baldengineer/Game-Gear-Cartridge-Breakout/game gear shim v11.stl

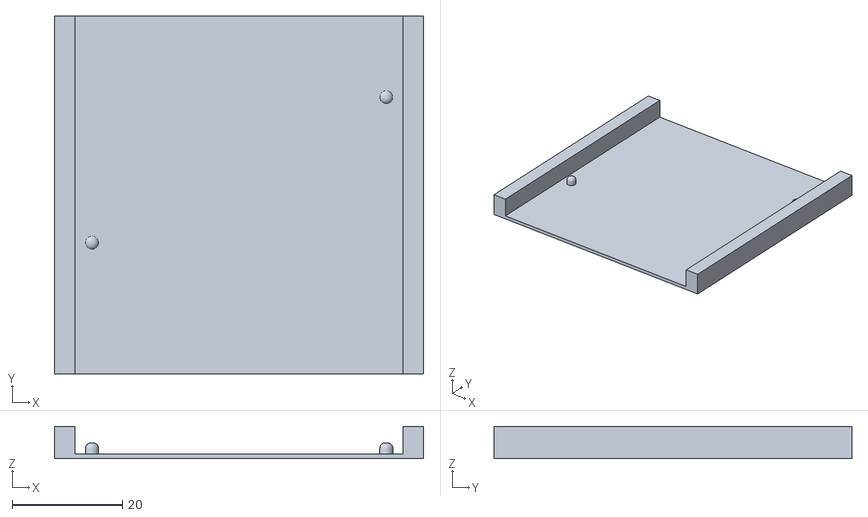
[picture p1: CAD file, 2023-01-09]
game gear shim v11.stl
67.0 x 65.0 x 5.90
