baldengineer/Game-Gear-Cartridge-Breakout/Game Gear Breakout Schematic v1.pdf

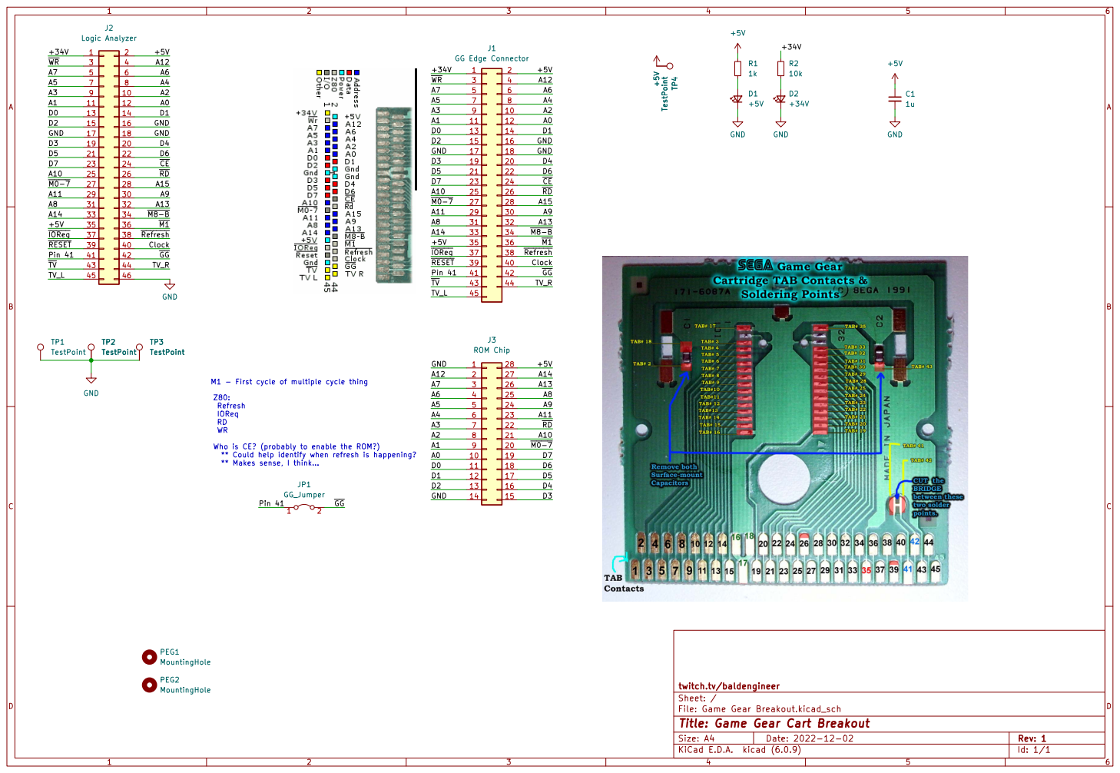
[picture p2: page 1]

Refresh
IOReq
WR Who is CE? (probably to enable the ROM?)

** Could help identify when refresh is happening?

File: Game Gear Breakout.kicad_sch Sheet: / twitch.tv/baldengineer

Id: 1/1 Title: Game Gear Cart Breakout
