baldengineer/Game-Gear-Cartridge-Breakout/Game Gear Breakout.kicad_pcb

## KiCad design Game Gear Breakout.kicad_pcb (2023-01-09)

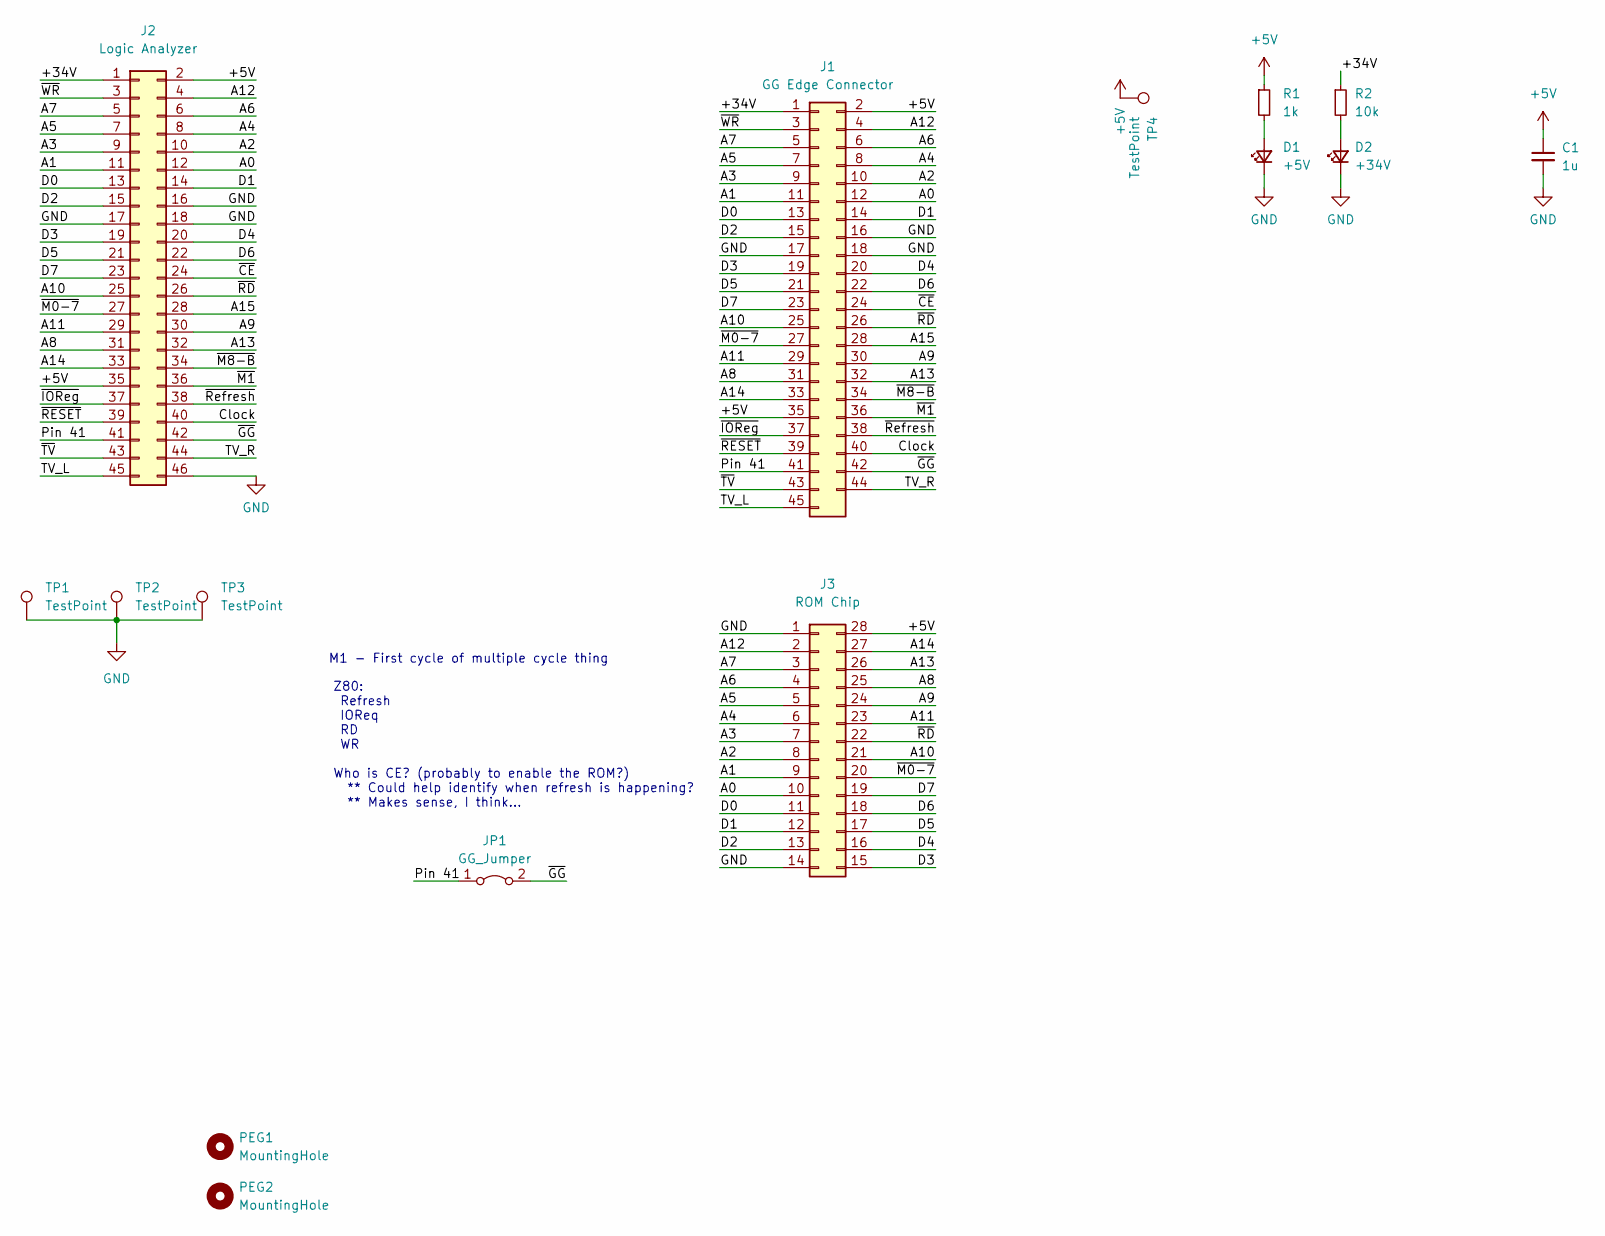
[picture p3: schematic Game Gear Breakout.kicad_sch, Game Gear Cart Breakout]

Parts:
C1: 1u; C_0805_2012Metric_Pad1.18x1.45mm_HandSolder
D1: +5V; LED_1206_3216Metric_Pad1.42x1.75mm_HandSolder
D2: +34V; LED_1206_3216Metric_Pad1.42x1.75mm_HandSolder
J1: GG Edge Connector; game gear edge connector
J2: Logic Analyzer; PinHeader_2x23_P2.54mm_Vertical
J3: ROM Chip; SOIC-28W_7.5x17.9mm_P1.27mm
JP1: GG_Jumper; SolderJumper-2_P1.3mm_Bridged_RoundedPad1.0x1.5mm
PEG1, PEG2: MountingHole; MountingHole_2.7mm_M2.5
R1: 1k; R_0805_2012Metric_Pad1.20x1.40mm_HandSolder
R2: 10k; R_0805_2012Metric_Pad1.20x1.40mm_HandSolder
TP1, TP2, TP3, TP4: TestPoint; Harwin-S1751-46-Test-Point

Connections:
+5V: C1.1, J1.2, J1.35, J2.2, J2.35, J3.28, R1.1, TP4.1
/+34V: J1.1, J2.1, R2.1
/A0: J1.12, J2.12, J3.10
/A1: J1.11, J2.11, J3.9
/A2: J1.10, J2.10, J3.8
/A3: J1.9, J2.9, J3.7
/A4: J1.8, J2.8, J3.6
/A5: J1.7, J2.7, J3.5
/A6: J1.6, J2.6, J3.4
/A7: J1.5, J2.5, J3.3
/A8: J1.31, J2.31, J3.25
/A9: J1.30, J2.30, J3.24
/A10: J1.25, J2.25, J3.21
/A11: J1.29, J2.29, J3.23
/A12: J1.4, J2.4, J3.2
/A13: J1.32, J2.32, J3.26
/A14: J1.33, J2.33, J3.27
/A15: J1.28, J2.28
/Clock: J1.40, J2.40
/D0: J1.13, J2.13, J3.11
/D1: J1.14, J2.14, J3.12
/D2: J1.15, J2.15, J3.13
/D3: J1.19, J2.19, J3.15
/D4: J1.20, J2.20, J3.16
/D5: J1.21, J2.21, J3.17
/D6: J1.22, J2.22, J3.18
/D7: J1.23, J2.23, J3.19
/Pin 41: J1.41, J2.41, JP1.1 (A)
/TV_L: J1.45, J2.45
/TV_R: J1.44, J2.44
/~CE: J1.24, J2.24
/~GG: J1.42, J2.42, JP1.2 (B)
/~IOReg: J1.37, J2.37
/~M0-7: J1.27, J2.27, J3.20
/~M1: J1.36, J2.36
/~M8-B: J1.34, J2.34
/~RD: J1.26, J2.26, J3.22
/~RESET: J1.39, J2.39
/~Refresh: J1.38, J2.38
/~TV: J1.43, J2.43
/~WR: J1.3, J2.3
GND: C1.2, D1.1 (K), D2.1 (K), J1.16, J1.17, J1.18, J2.16, J2.17, J2.18, J2.46, J3.1, J3.14, TP1.1, TP2.1, TP3.1
unnamed: D1.2 (A), R1.2
unnamed: D2.2 (A), R2.2

Notes on the sheet:
Z80: Refresh IOReq RD WR Who is CE? (probably to enable the ROM?) ** Could help identify when refresh is happening? ** Makes sense, I think...
M1 - First cycle of multiple cycle thing

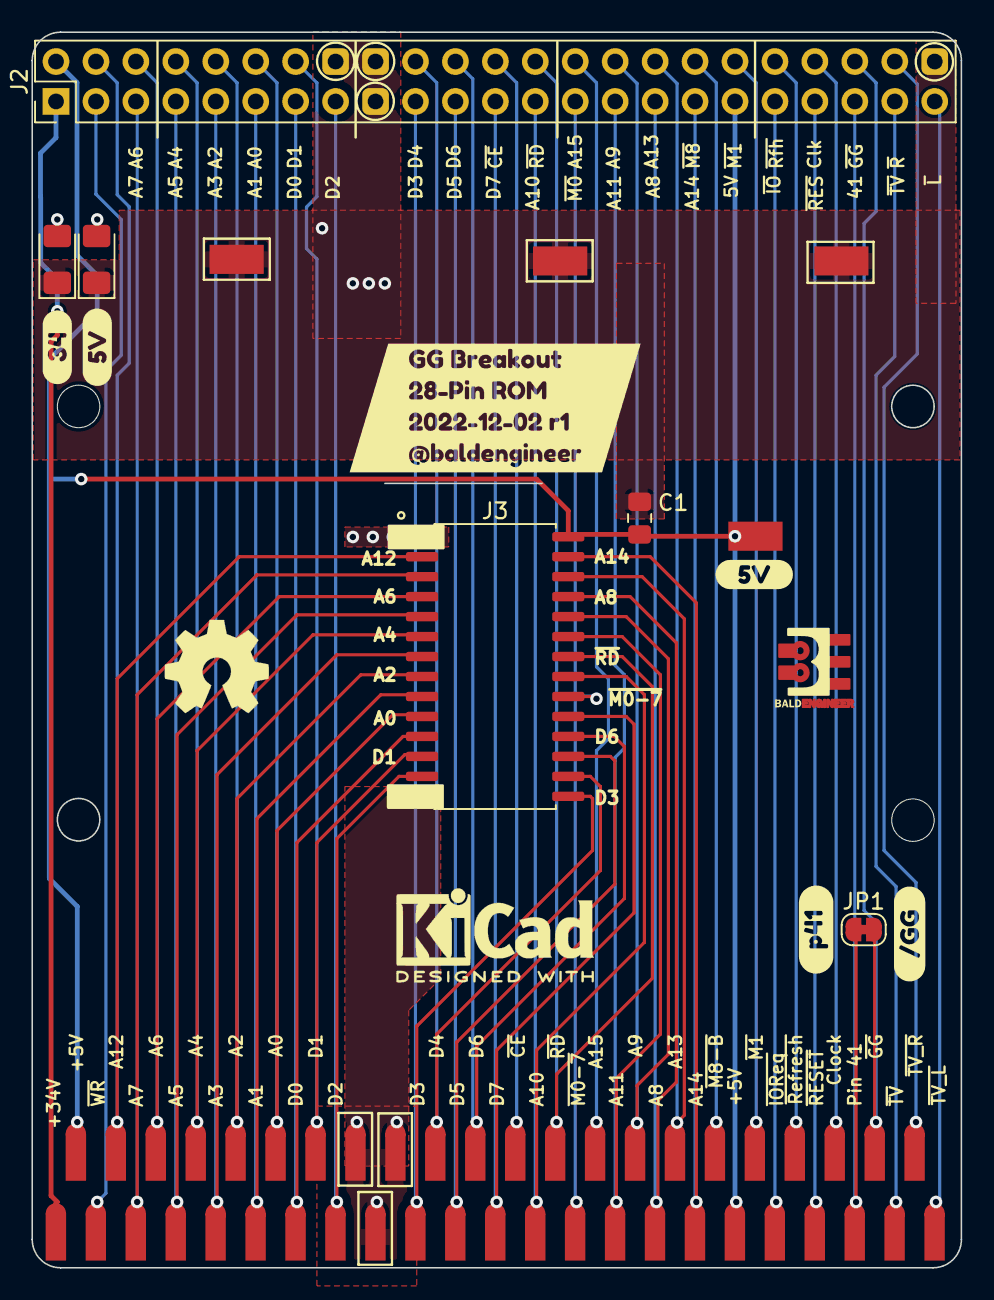
[picture p4: board Game Gear Breakout.kicad_pcb from above]

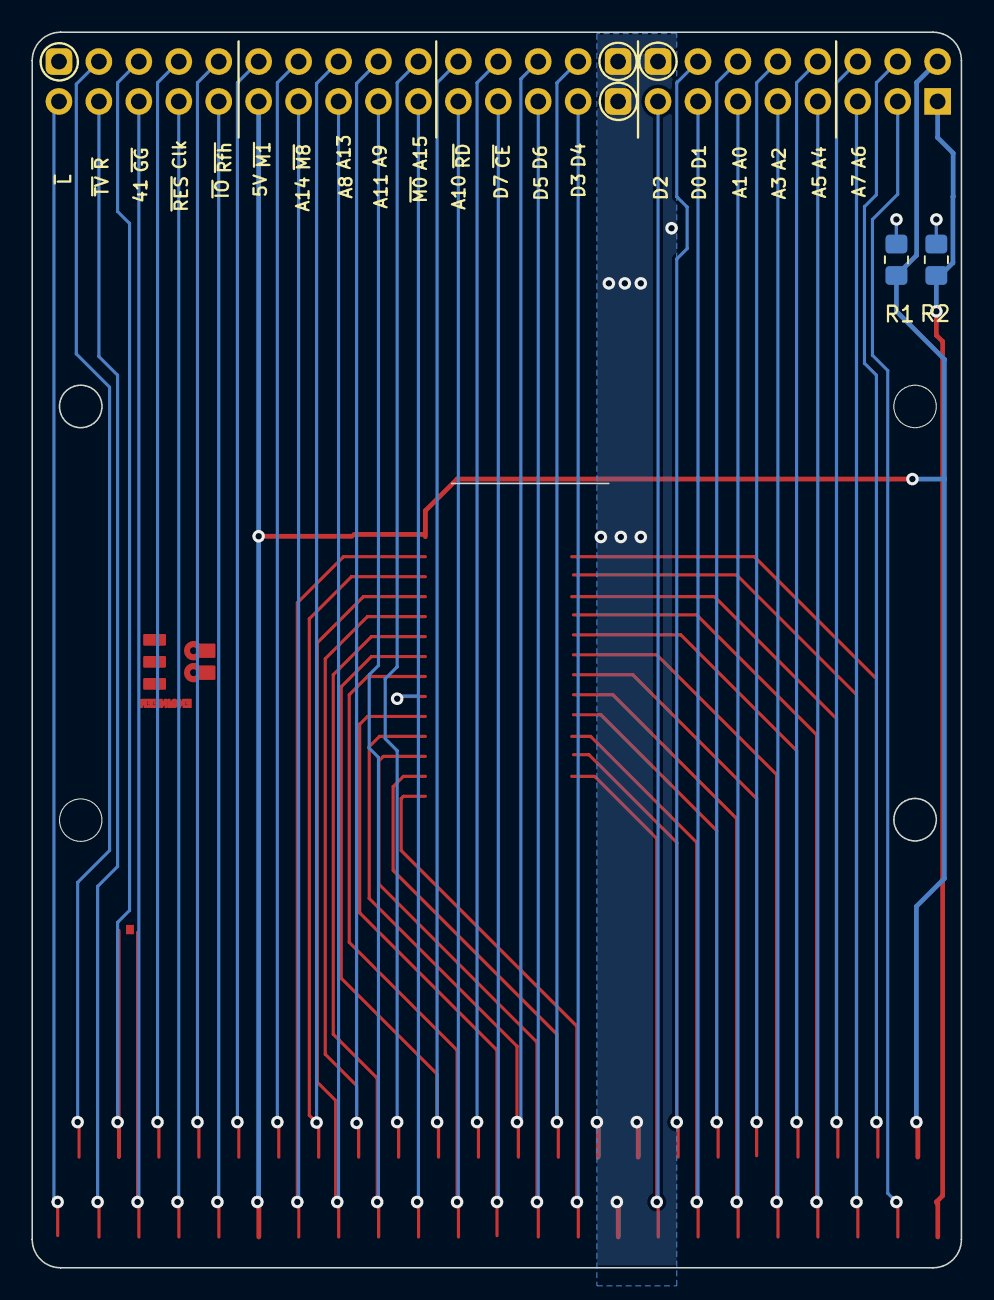
[picture p5: board Game Gear Breakout.kicad_pcb from below]

Board: 2 copper layers, 59.1 x 78.6 mm, 22 parts (2 on the bottom side), 44 nets.

Other parts of the board:
kibuzzard-638A45B3, kibuzzard-638A45B3#2: G***; kibuzzard-638A45B3
kibuzzard-638A45BD: G***; kibuzzard-638A45BD
kibuzzard-638A50E1: G***; kibuzzard-638A50E1
kibuzzard-638A474E: G***; kibuzzard-638A474E
kibuzzard-638A4743: G***; kibuzzard-638A4743
svg2mod: G***; BE5v2
