baldengineer/Game-Gear-Cartridge-Breakout/(threads)

Thread 1 (2023-01-07):

Wrong footprint for 28-pin ROM

baldengineer, 2023-01-07:
The masked ROM is wider than a standard SOIC!

Thread 2 (2023-01-07):

Use >10 kOhm for 34V LED

baldengineer, 2023-01-07:
With a 1k current limiting resistor for the 34V LED the Game Gear won't power on.
