baldengineer/Game-Gear-Cartridge-Breakout/(commit log)

2022-12-02 starting pcb
    [Game Gear Breakout.kicad_pcb, Game Gear Breakout.kicad_sch]
2022-12-02 added gnd to pin 46 of LA
    [Game Gear Breakout.kicad_sch]
2022-12-02 DRC rules for PCB
2022-12-02 bottom routed (try #1)
    [Game Gear Breakout.kicad_pcb, Game Gear Breakout.kicad_sch]
2022-12-02 rev1 layout done?
    [Game Gear Breakout.kicad_pcb, Game Gear Breakout.kicad_sch]
2022-12-02 v1 submitting to fab
    [Game Gear Breakout.kicad_pcb, Game Gear Breakout.kicad_sch]
2022-12-02 gerbs and pdf of schematic (v1)
    [Game Gear Breakout-B_Cu.gbr, Game Gear Breakout-B_Mask.gbr, Game Gear Breakout-B_Paste.gbr, Game Gear Breakout-B_Silkscreen.gbr, Game Gear Breakout-Edge_Cuts.gbr, Game Gear Breakout-F_Cu.gbr, Game Gear Breakout-F_Mask.gbr, Game Gear Breakout-F_Paste.gbr]
2023-01-09 3d printable shim (so pcb fits in slot)
    [Game Gear Breakout.kicad_pcb, game gear shim v11.stl]
